WQM-Project/edge-sensing-node/(commit log)

2026-09-13 docs: add edge-sensing-node README with sensor suite, JSON format, and build guide
2026-10-09 feat: add STM32F7 HAL drivers, core firmware, and GPS/BNO085 sensor modules
2026-11-07 feat: add STM32F7 HAL MSP initialization and main application source files
2026-11-07 fix(sensors): update TDS to PA5, ORP to PC3 with 20-sample trimmed-mean, calibrate DO on PA4 with temp compensation
2026-11-12 Sync pH/TDS calibration constants and BMP280/active sensor docs
2026-11-12 Finish BMP280, 7.5% KCl, and calibration doc sync in edge-sensing-node
2026-11-12 Align quick-reference JSON output example with 19-field STM32 build
2026-11-12 docs: update telemetry architecture to direct onboard STM32-ESP32 UART + SIM7600 4G/GNSS
2026-11-12 feat(uart): send telemetry packets over UART4 with ACK/NAK retry and float guards
