WQM-Project/edge-sensing-node/(notices)

Notices in the files:
Core/Inc/main.h:
Copyright (c) 2026 STMicroelectronics.
All rights reserved.
This software is licensed under terms that can be found in the LICENSE file
Instruction-Manual-for-DO-Probe-Sensor-for-Arduino.md:
FFFFABRRRQAUUUUAFFFFABRRRQAUUUUAFFFFABRRRQAUUUUAfOP7a3xM8Z/DeHwxL4R1c6f9t+1m5H2eKXzNnkbf9YrYxvbpjrXw/8AEXxz4j+IHiL+3vFWpvfXwhWBXMUce2NSSFAQKOrMenevq7/gpL/x4+Dfpf8A/ttXxOaBkwKj+M/lXZ/C74neL/htdXs/hLWHsGvkRLgeRFIH2klch1Ycbm6etcNT4vvj60wP0w/ZA8beJPHvwuutc8U6ib++XVJIFk8mOLEYiiYDCKo6u3OM817LXzv/AME/f+SH3
